avignatenko/sim-cable-box/stl/sim_rig_cable_box_lid.stl

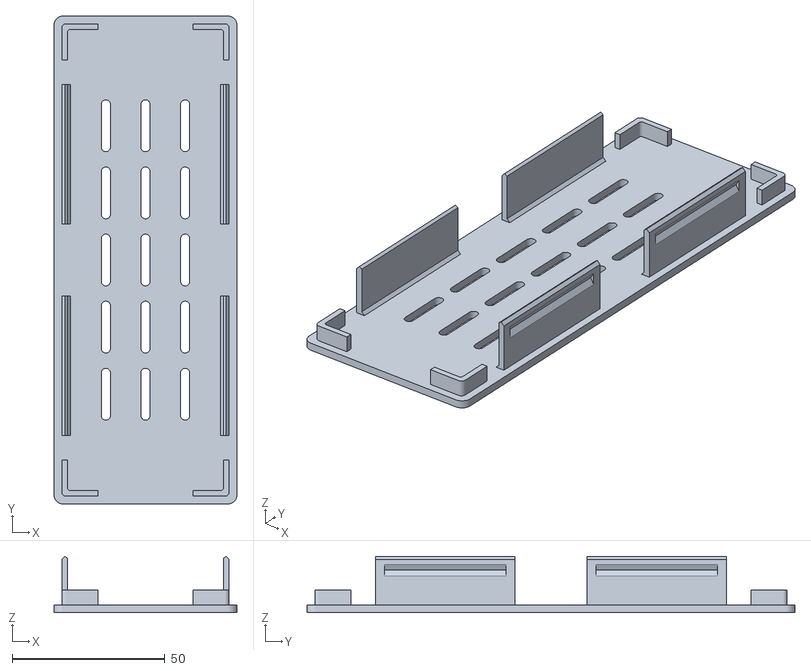
[picture p3: CAD file, 2026-10-10]
stl/sim_rig_cable_box_lid.stl
60.0 x 160.0 x 18.4
