avignatenko/sim-cable-box/stl/sim_rig_cable_box_box.stl

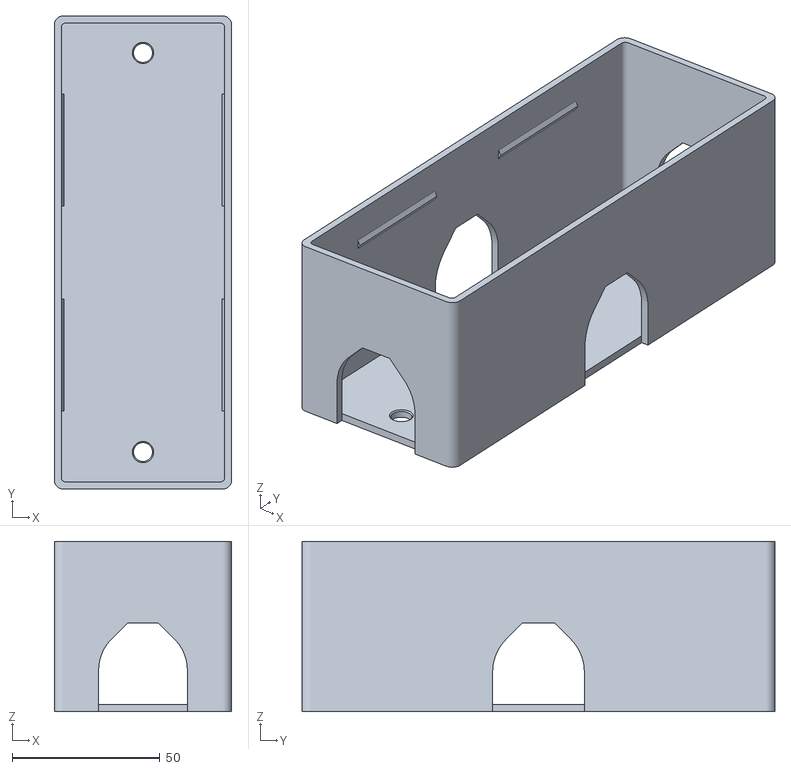
[picture p4: CAD file, 2026-10-10]
stl/sim_rig_cable_box_box.stl
60.0 x 160.0 x 57.6
