avignatenko/sim-cable-box/(commit log)

2026-10-10 fixes after print
    [sim_rig_cable_box.scad, sim_rig_cable_box.stl, sim_rig_cable_box_box.stl, sim_rig_cable_box_lid.stl]
2026-10-10 removed wrong file
    [sim_rig_cable_box.stl]
